neuralzome/flo_edge/README.md

# Flo Edge

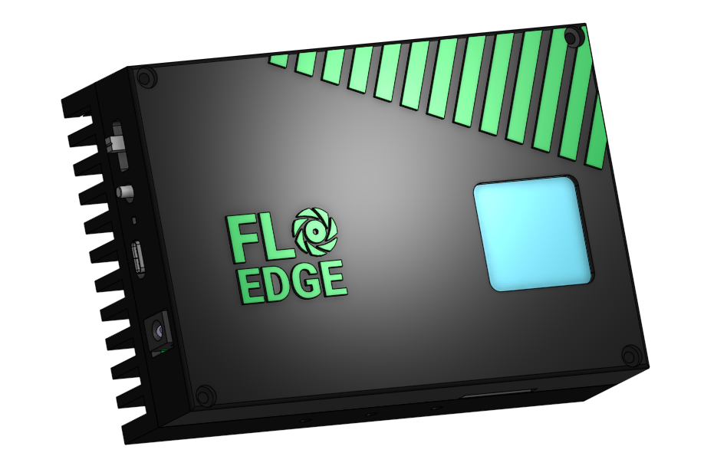
[picture p1: flo_edge.png]
flo_edge


> Mobile phone SOM based compute, sensor & comms platform for ai and robotics application

## Reference
1. [aidlux](https://www.youtube.com/watch?v=y_1fQNMngR8)
2. [comma ai](https://comma.ai/)
