neuralzome/flo_edge/pocof1/README.md

# Pocophone f1

Poco F1

* [Teardown](https://www.youtube.com/watch?v=L5VWWba0coY)
* [Schematic](./schematic.pdf)
