neuralzome/flo_edge/flo_pcb/pcba.png

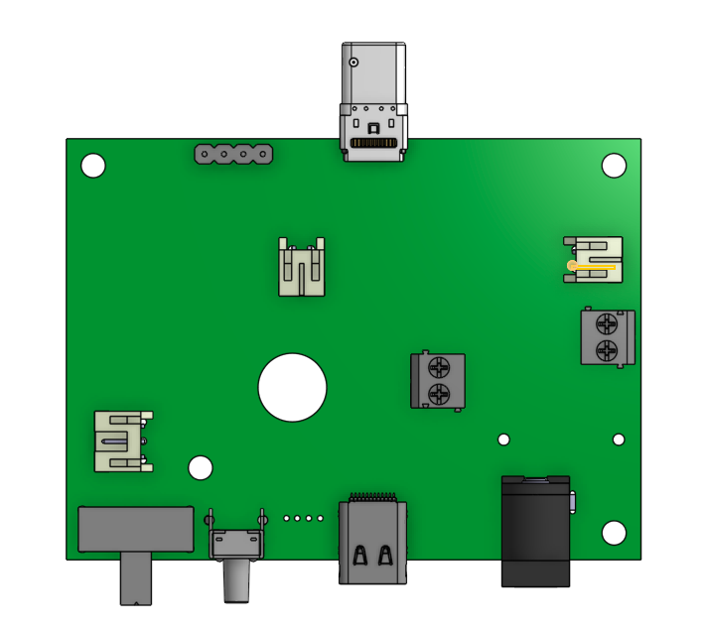
flo_pcb/pcba.png
