neuralzome/flo_edge/pocof1/imgs/bms_pcb.png

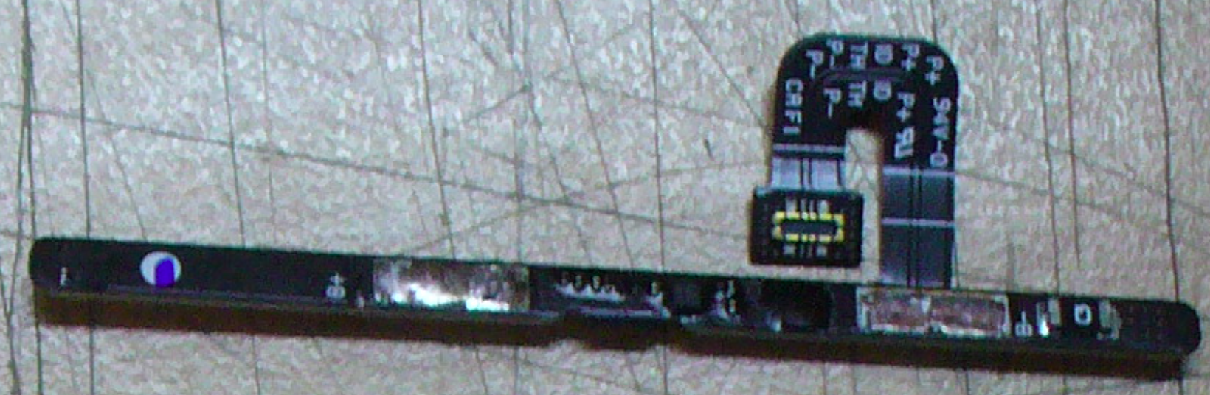
pocof1/imgs/bms_pcb.png
