neuralzome/flo_edge/pocof1/imgs/charging_pcb_back.png

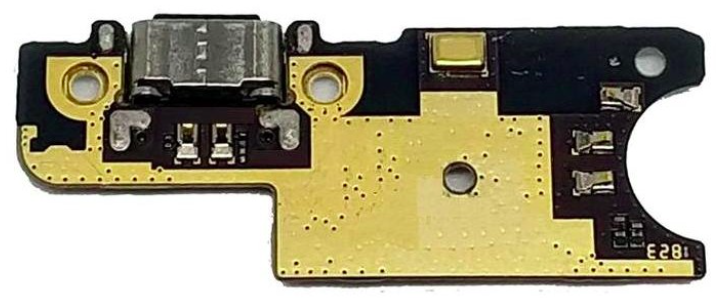
pocof1/imgs/charging_pcb_back.png
