neuralzome/flo_edge/pocof1/imgs/charging_pcb_front.png

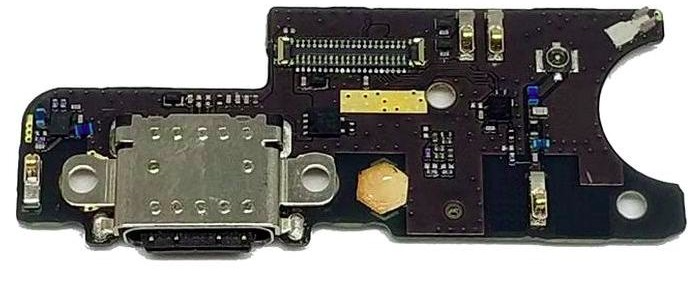
pocof1/imgs/charging_pcb_front.png
