neuralzome/flo_edge/pocof1/imgs/signal_cable.png

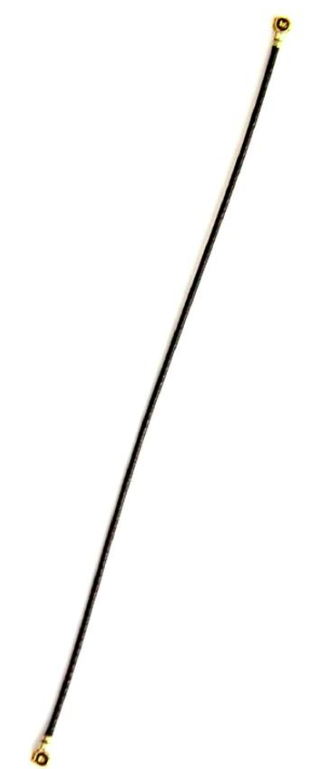
pocof1/imgs/signal_cable.png
