neuralzome/flo_edge/pocof1/imgs/som_back.png

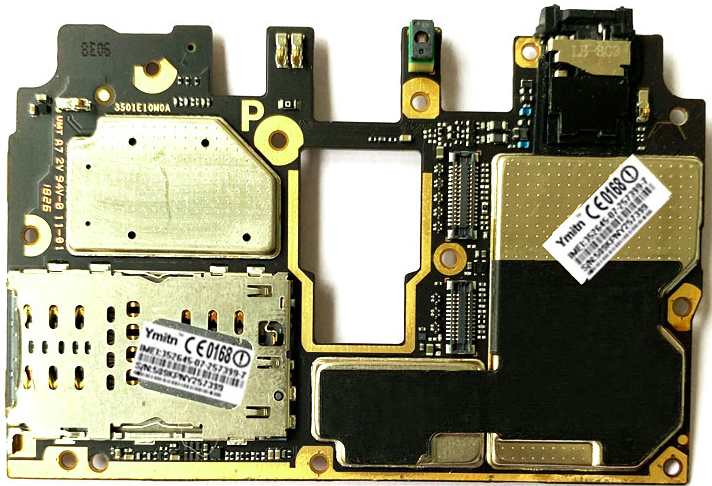
pocof1/imgs/som_back.png
