neuralzome/flo_edge/pocof1/imgs/som_front.png

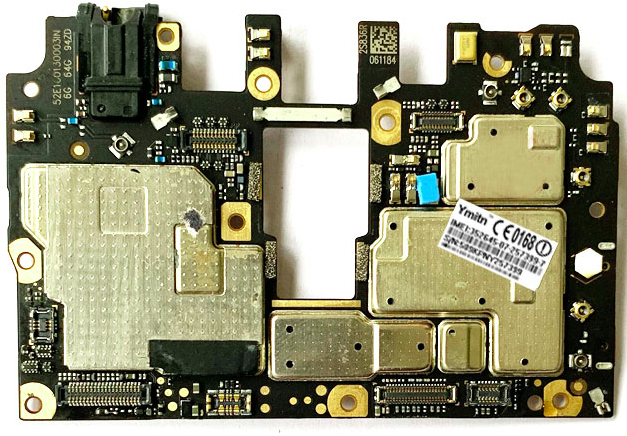
pocof1/imgs/som_front.png
