neuralzome/flo_edge/flo_pcb/bom.xls

BOM: FLO Mobility V0.0
Assembly Part Number:
Company Name:
Item # | Reference designators | Device | Part description/ specs (optional, but recommended) | Size / Footprint (optional) | Value (optional) | Manfacturer (optional) | Manufacturer Part # | Vendor (optional) | Vendor Part Number (optional) | Quantity per board | Unit Price MOQ 1 | Total MOQ 1 | Unit Price MOQ 10 | Total MOQ 10 | Unit Price MOQ 100 | Total MOQ 100 | Comments
1 | R1 | Resistor | RES 1M OHM 5% 1/10W 0603 | R0603 | 1M | WR06X105 JTL | Walsin Technology Corporation |  | 1292-WR06X105JTLCT-ND | 1 | 0.1 | 0.1
2 | R2,R18,R3 | Resistor | RES 10K OHM 1% 1/8W 0603 | R0603 | 10K | Stackpole Electronics Inc | RNCP0603FTD10K0 |  | RNCP0603FTD10K0CT-ND | 3 | 0.1 | 0.3
3 | R6,R10,R20,R14,R5,R9,R8,R4,R15,R19,R16 | Resistor | RES 1K OHM 1% 1/8W 0603 | R0603 | 1K | Stackpole Electronics Inc | RNCP0603FTD1K00 |  | RNCP0603FTD1K00CT-ND | 11 | 0.1 | 1.1
4 | R12,R13,R21,R7,R11 | Resistor | RES 100K OHM 1% 1/10W 0603 | R0603 | 100K | YAGEO | RC0603FR-07100KL |  | 311-100KHRCT-ND | 9 | 0.1 | 0.9
5 | R17 | Resistor |  | R0603 | 45.3K |  |  |  |  | 1 |  | 0
6 | C1, C2, | Capacitor | CAP CER 20PF 50V C0G/NP0 0603 | C0603 | 20pF | Samsung Electro-Mechanics | CL10C200JB8NNNC |  | 1276-1187-1-ND | 2 | 0.1 | 0.2
7 | C4,C7,C3,C5,C6 | Capacitor | CAP CER 1UF 25V X7R 0603 | C0603 | 1uF | Samsung Electro-Mechanics | CL10B105KA8NNNC |  | 1276-1184-1-ND | 5 | 0.1 | 0.5
8 | C9 | Capacitor | CAP CER 0.1UF 25V X7R 0603 | C0603 | 0.1uF | Samsung Electro-Mechanics | CL10B104KA8NNNC |  | 1276-1006-1-ND | 1 | 0.1 | 0.1
9 | C15 | Capacitor |  | C0603 | 400uF |  |  |  |  |  |  | 0
10 | C8,C10,C11 | Capacitor | CAP CER 10UF 35V X5R 0603 | C0603 | 10uF | Murata Electronics | GRM188R6YA106MA73J |  | 490-GRM188R6YA106MA73JCT-ND | 3 | 0.24 | 0.72
11 | Q1, | MOSFET N-CH | MOSFET N-CH 30V 3.6A SOT23 | SOT-23-3 |  | Diodes Incorporated | DMG3406L-13 |  | DMG3406L-13DITR-ND | 1 | 0.44 | 0.44
12 | Q2, Q3, Q4, Q5, | TRANS NPN | TRANS NPN 45V 0.5A TO236AB | SOT-23-3 |  | Nexperia USA Inc. | BC817-25_215 |  | 1727-2918-1-ND | 4 | 0.16 | 0.64
13 | L1, | Inductor | FIXED IND 3.3UH 11.4A 12.8 MOHM |  | 33uH | KEMET | MPXV1D1040L3R3 |  | 399-MPXV1D1040L3R3DKR-ND | 1 | 0.87 | 0.87
14 | LED1, | LED | LED GREEN CLEAR 0805 SMD | 805 |  | Würth Elektronik | 150080GS75000 |  | 732-4983-1-ND | 1 | 0.19 | 0.19
15 | LED2, | LED | RGB LAMP |  | RGB | Everlight Electronics Co Ltd | EALP05RDMRGBA0 |  | 1080-EALP05RDMRGBA0-ND | 1 | 1.63 | 1.63
16 | CR1 | TVS Diode | TVS DIODE 20VWM 34VC DFN1006-2 |  |  | Diodes Incorporated | D20V0L1B2LP-7B |  | D20V0L1B2LP-7BDICT-ND | 1 | 0.27 | 0.27
17 | D1, D2, D3, | Diode | DIODE SCHOTTKY 30V 800MA USC |  |  | Toshiba Semiconductor and Storage | CUS08F30 |  | CUS08F30H3FCT-ND | 3 | 0.33 | 0.99
18 | J1, | Programming Conn | CONN HEADER VERT 4POS 2.54MM |  |  | Sullins Connector Solutions | PREC004SAAN-RC |  | S1012EC-04-ND | 1 | 0.12 | 0.12
19 | J2, | KeyPad | CONN HEADER R/A 3POS 2MM |  |  | JST Sales America Inc. | S3B-PH-K-S(LF)(SN) |  | 455-1720-ND | 1 | 0.19 | 0.19
20 | J3 | Temp | CONN HEADER R/A 2POS 2MM |  |  | JST Sales America Inc. | S2B-PH-K-S(LF)(SN) |  | 455-1719-ND | 1 | 0.17 | 0.17
21 | J4, J7 | Fan | TERM BLK 2POS SIDE ENT 3.5MM PCB |  |  | TE Connectivity AMP Connectors | 1776275-2 |  | A98036-ND | 2 | 0.44 | 0.88
22 | J5 | USB-C-F | CONN RCP USB3.1 TYPEC 24P SMD RA |  |  | Assmann WSW Components | CONN RCP USB3.1 TYPEC 24P SMD RA |  | AE11237DKR-ND | 1 | 3.32 | 3.32
23 | J6, | USB-C-M | USB TYPE C, PLUG, SMT , G/F, RIG |  |  | GCT | USB4155-03-C |  | 2073-USB4155-03-CDKR-ND | 1 | 1.69 | 1.69
24 | J8, | CONN | CONN PWR JACK 2.1X5.5MM SOLDER |  |  | MPD (Memory Protection Devices) | EJ508A |  | EJ508A-ND | 1 | 1.38 | 1.38
25 | S1, | Switch | SWITCH TACTILE SPST-NO 0.05A 12V |  |  | E-Switch | TL1105SF250Q |  | EG1840-ND | 1 | 0.37 | 0.37
26 | SW1 | Switch | SWITCH SLIDE SPDT 300MA 30V |  |  | C&K | SK12F17G7 |  | CKN10393-ND | 1 | 0.77 | 0.77
27 | U1 | IC REG | IC REG BUCK ADJ 5A TSOT23-6 |  |  | Texas Instruments | TPS565208DDCR |  | 296-48755-1-ND | 1 | 1.48 | 1.48
28 | U2, | IC REG | IC REG LINEAR 3.3V 1A SOT223 |  | 3.3V | onsemi | NCV1117ST33T3G |  | NCV1117ST33T3GOSCT-ND | 1 | 0.71 | 0.71
29 | U3, | MCU | IC MCU 32BIT 256KB FLASH 48LQFP |  |  | STMicroelectronics | STM32F030CCT6 |  | 497-17296-ND | 1 | 4.08 | 4.08
30 | FB2,FB1 | FERRITE | FERRITE BEAD 30 OHM 0805 1LN |  |  | Würth Elektronik | 742792030 |  | 732-742792030CT-ND | 1 | 0.23 | 0.23
31 | Y1, | CRYSTAL | CRYSTAL 8.0000MHZ 20PF SMD |  | 8MHz | Abracon LLC | ABLS-8.000MHz-20-B-3-H-T |  | 535-14944-1-ND | 1 | 0.17 | 0.17
END OF BOM |  |  |  |  |  |  |  |  |  | Total Cost Per PCB (USD): |  | 24.51 |  | 0 |  | 0
BOM Created By : Rahul Kumar
BOM Verified By :
