neuralzome/flo_edge/flo_pcb/schematics.pdf

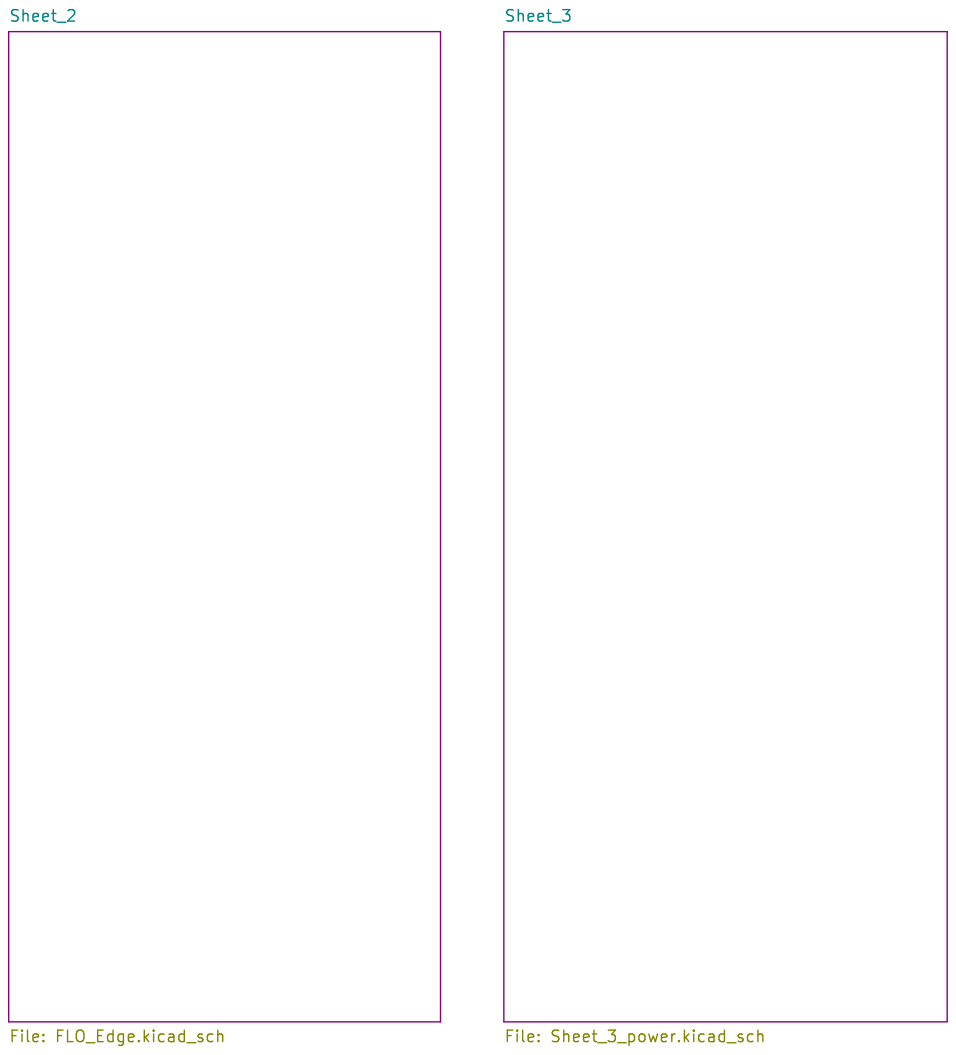
[picture p9: page 1]

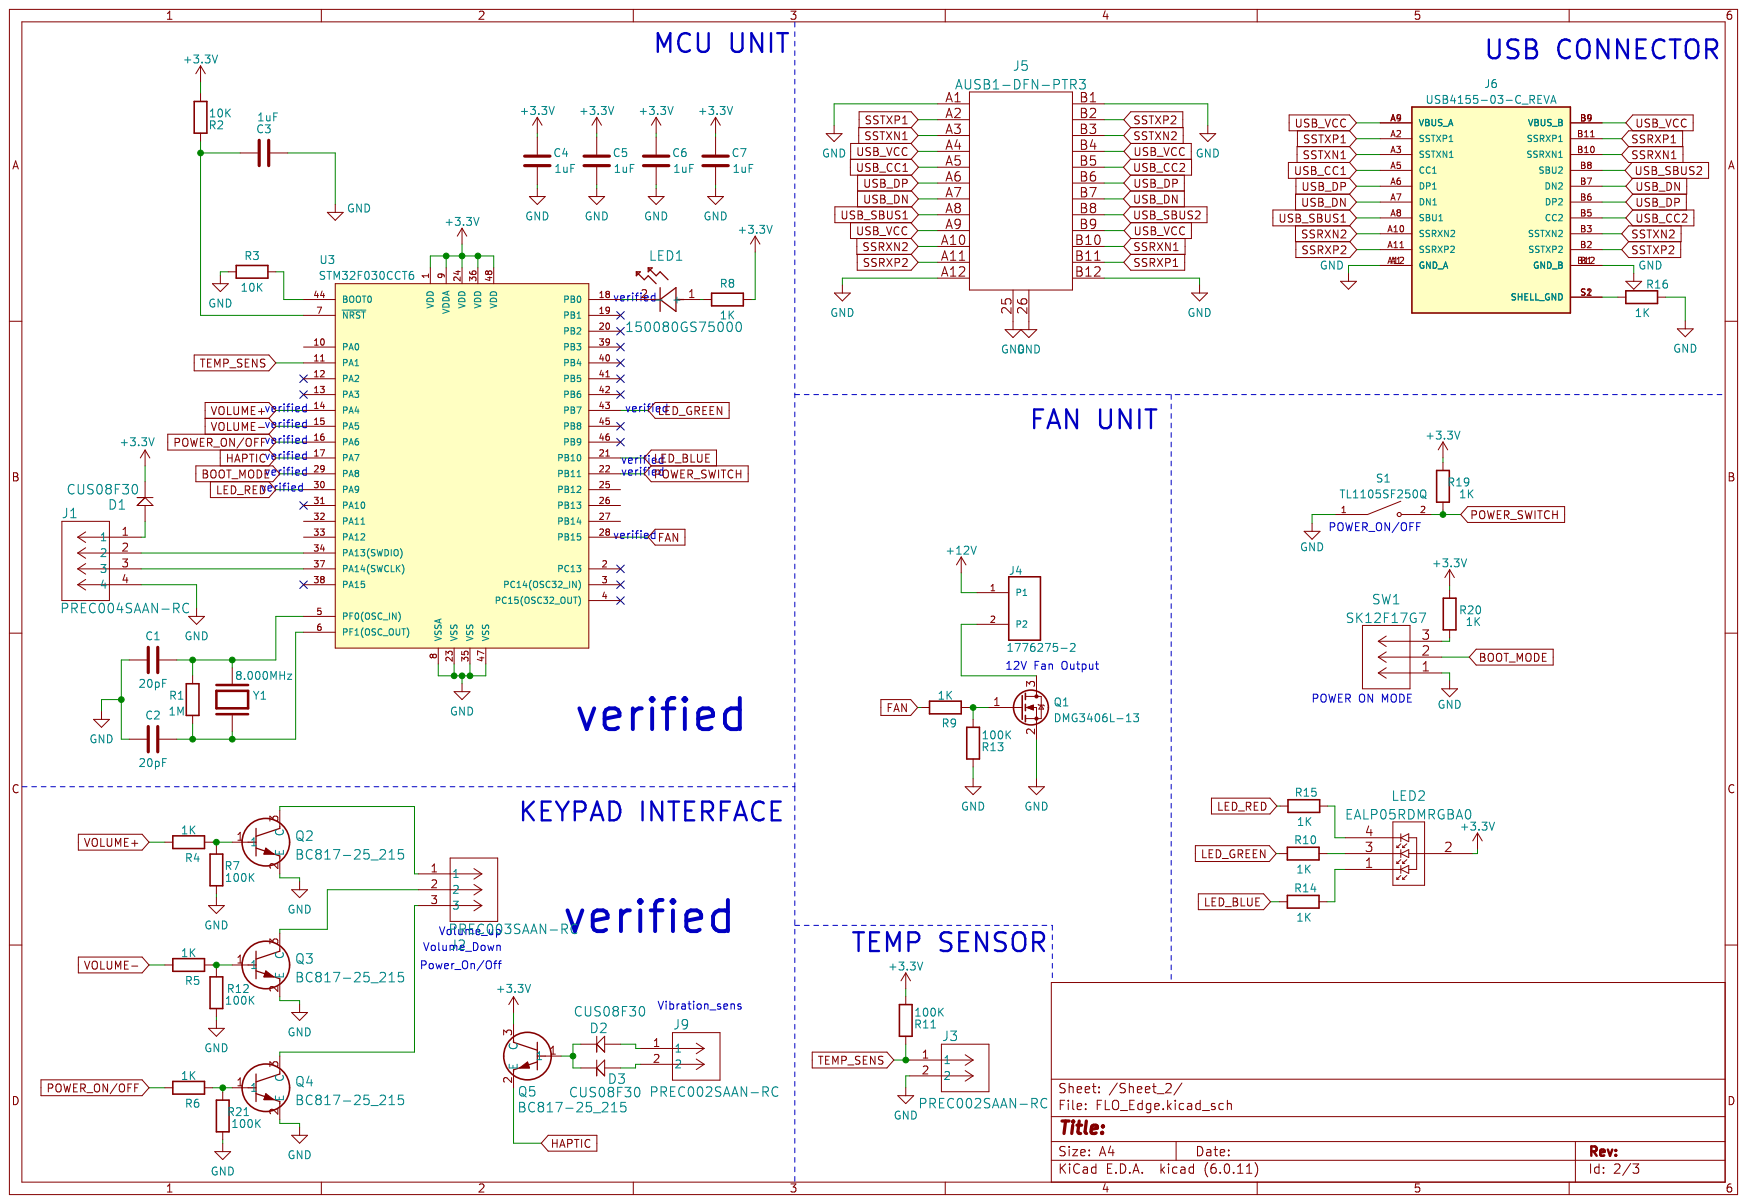
[picture p10: page 2]

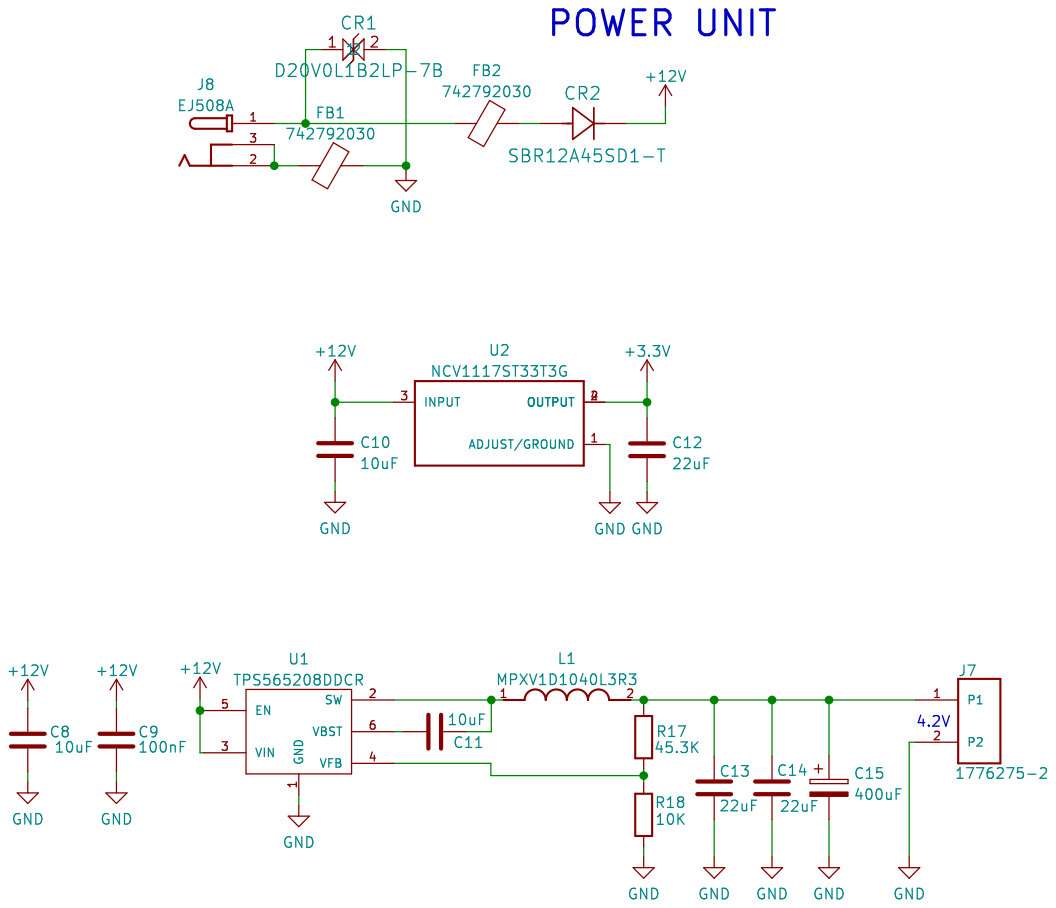
[picture p11: page 3]
