neuralzome/flo_edge/flo_pcb/layout.pdf

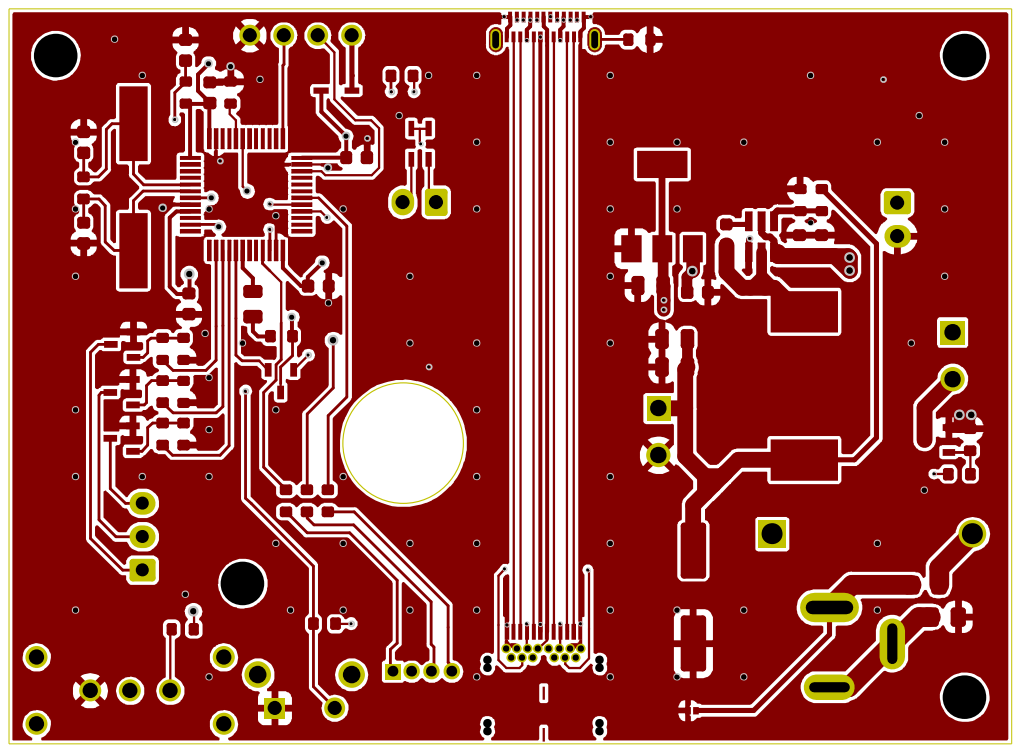
[picture p12: page 1]

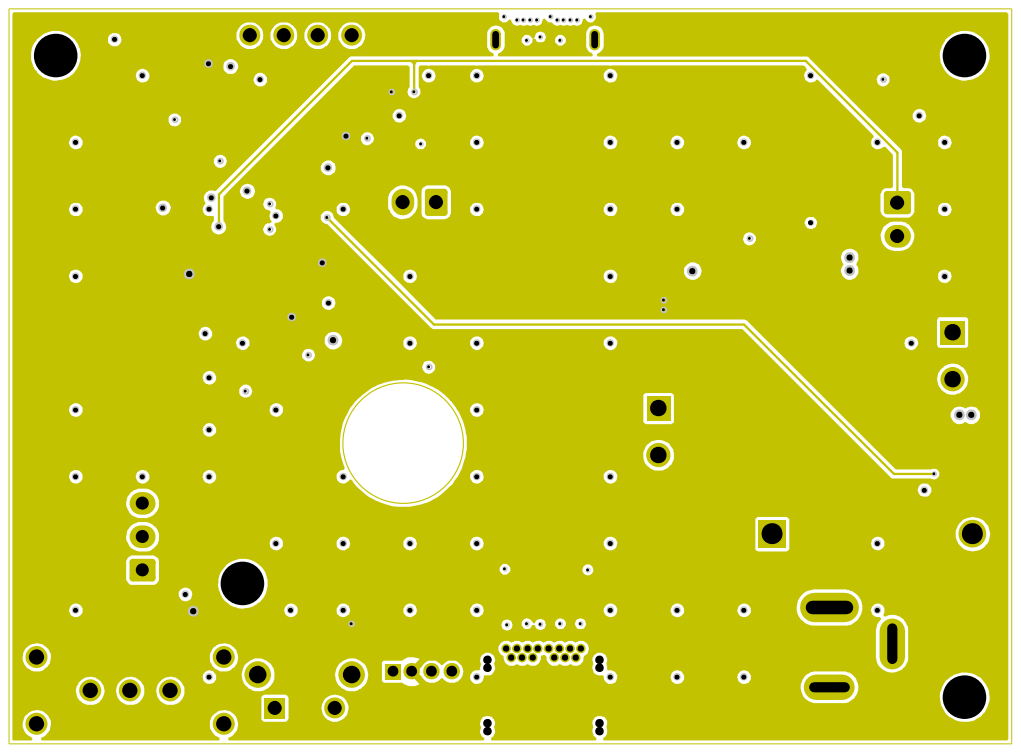
[picture p13: page 2]

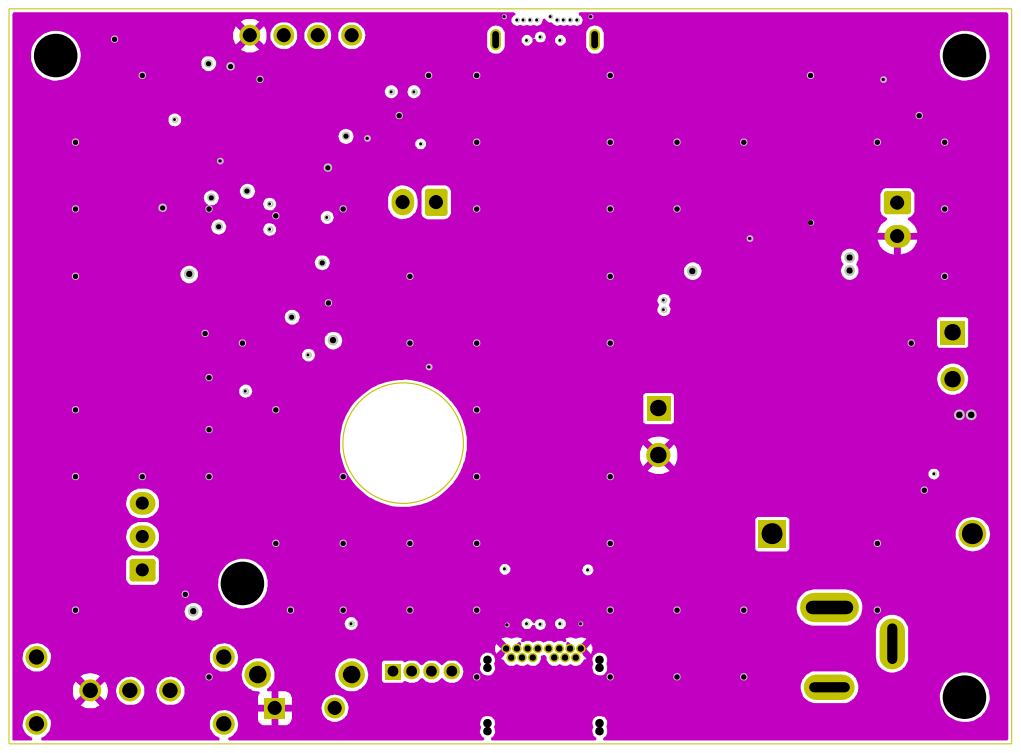
[picture p14: page 3]

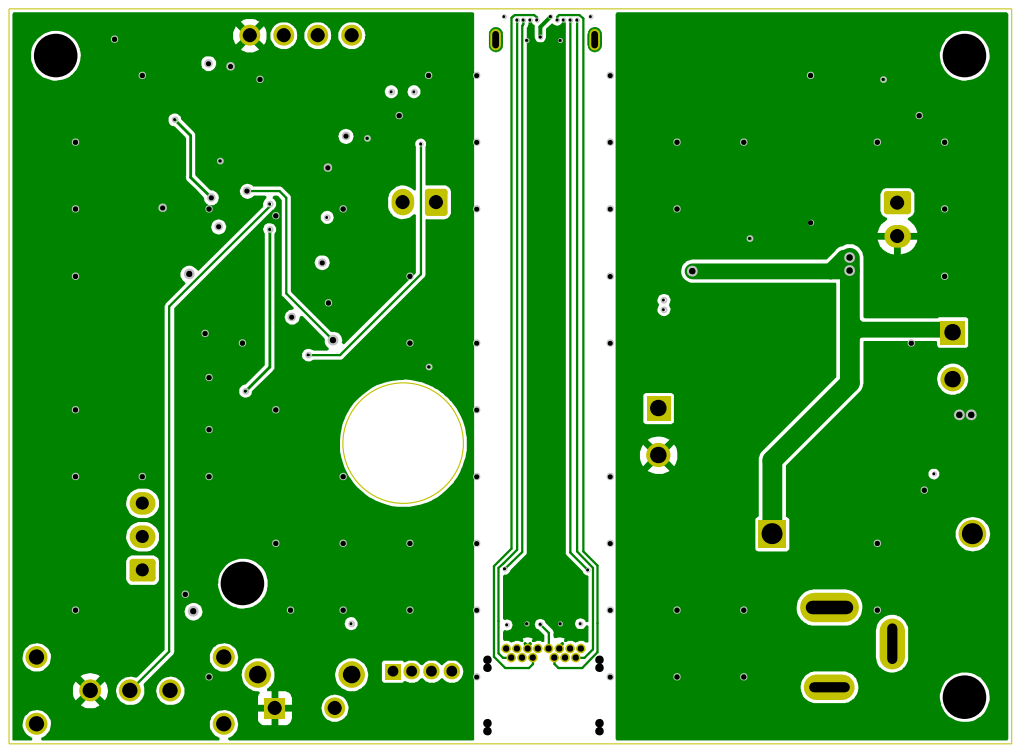
[picture p15: page 4]

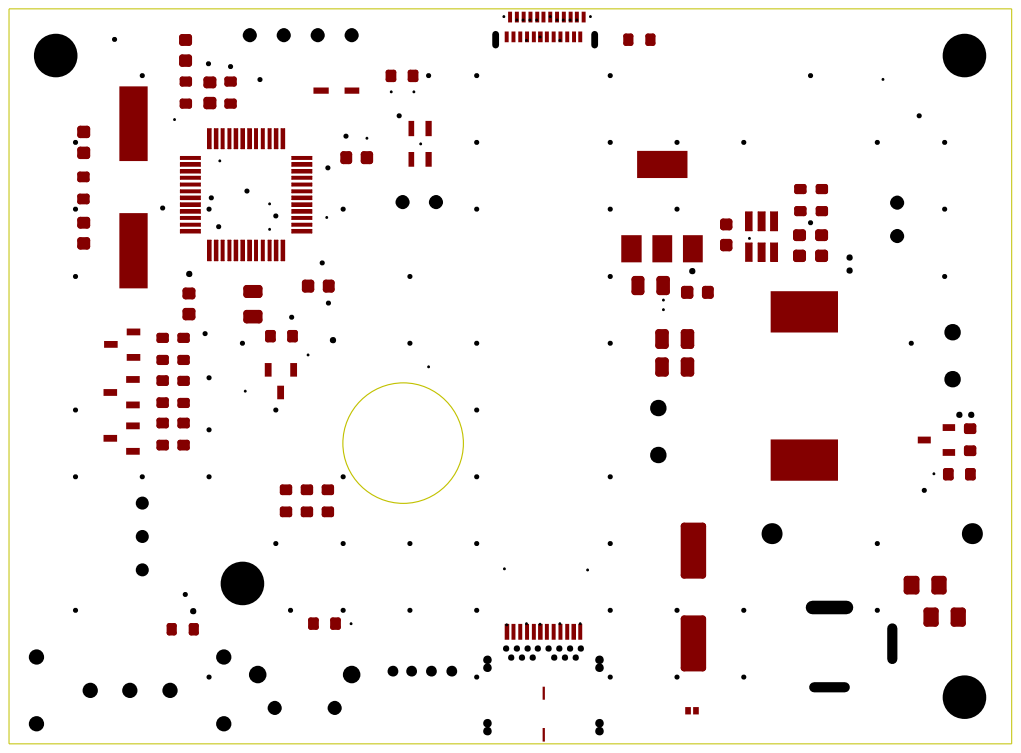
[picture p16: page 5]

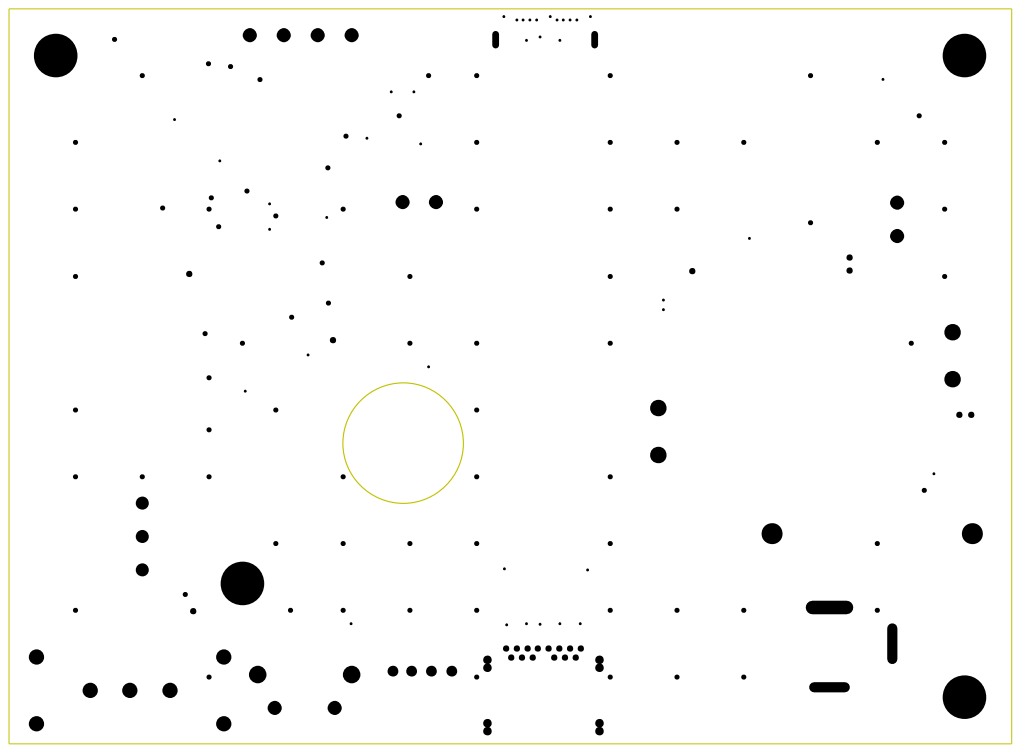
[picture p17: page 6]

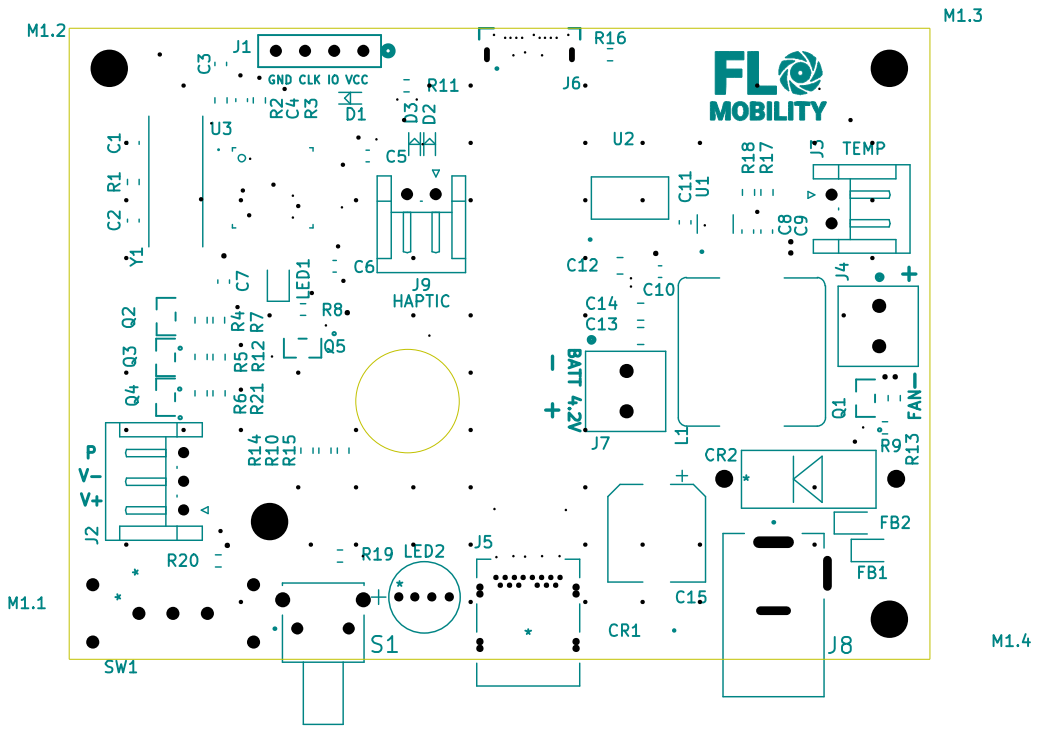
[picture p18: page 7]

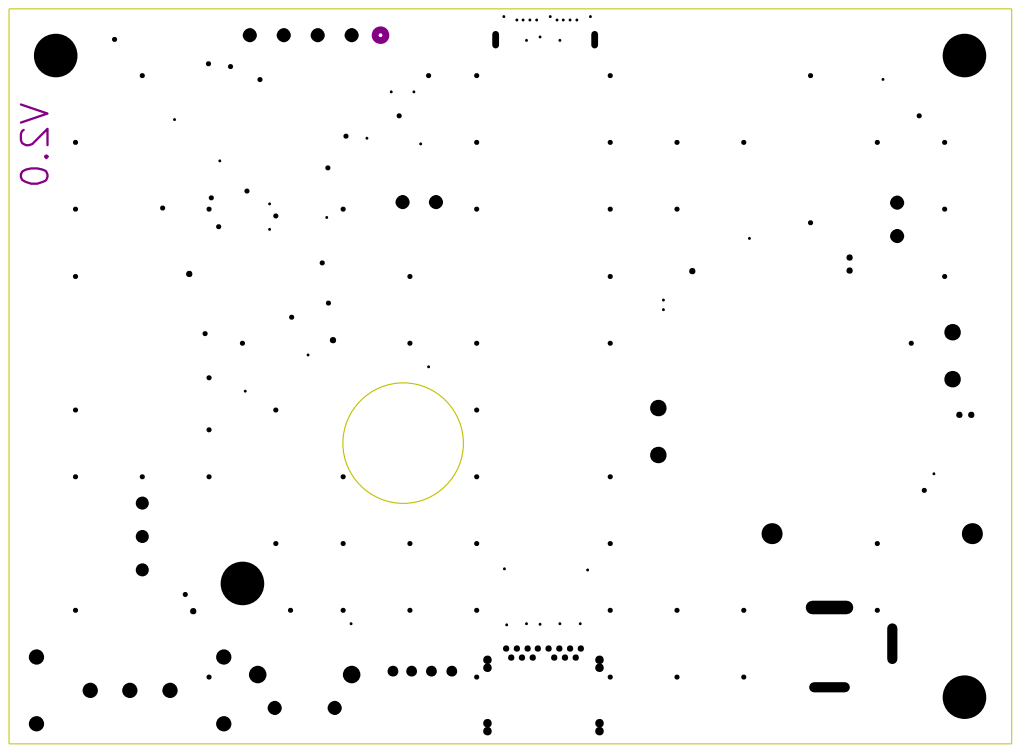
[picture p19: page 8]

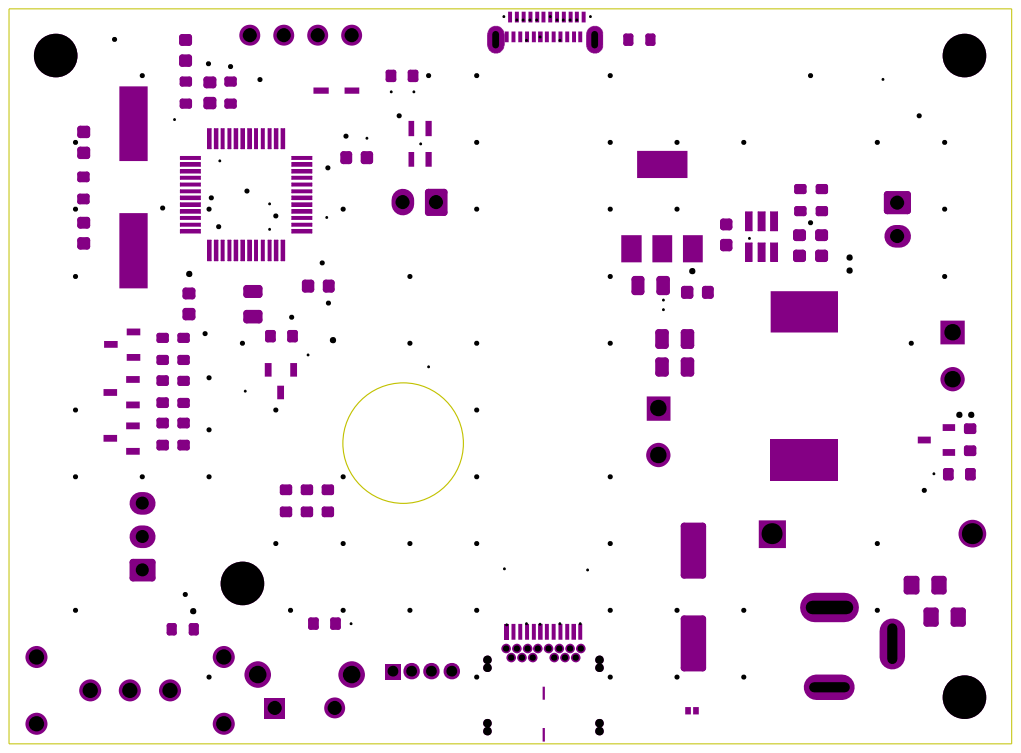
[picture p20: page 9]

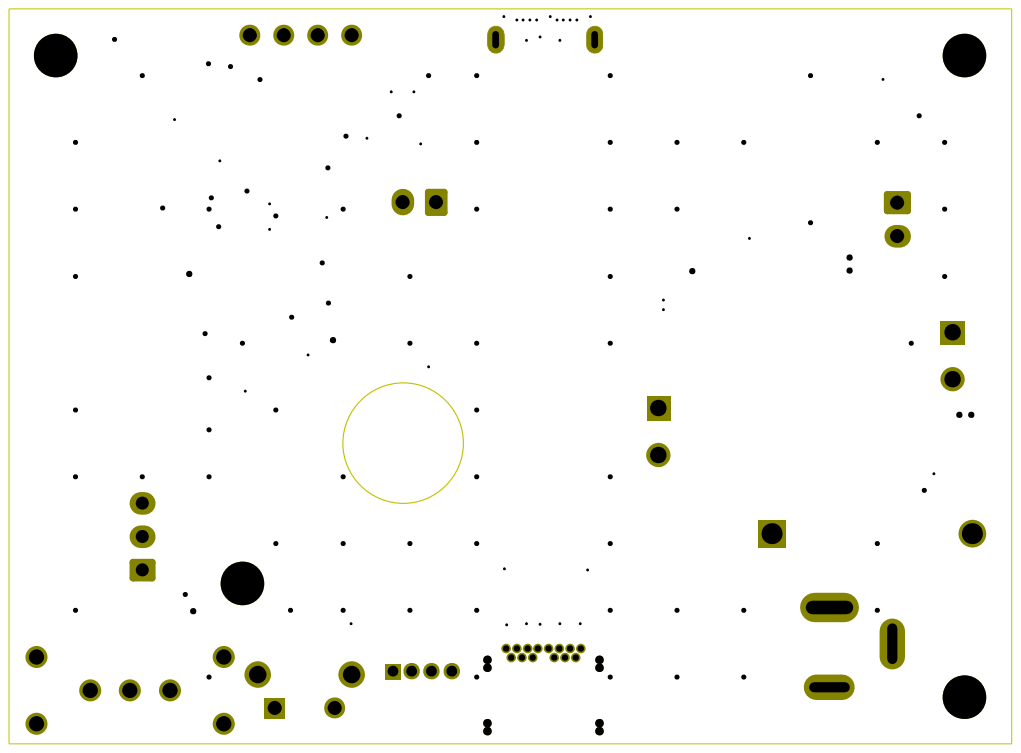
[picture p21: page 10]

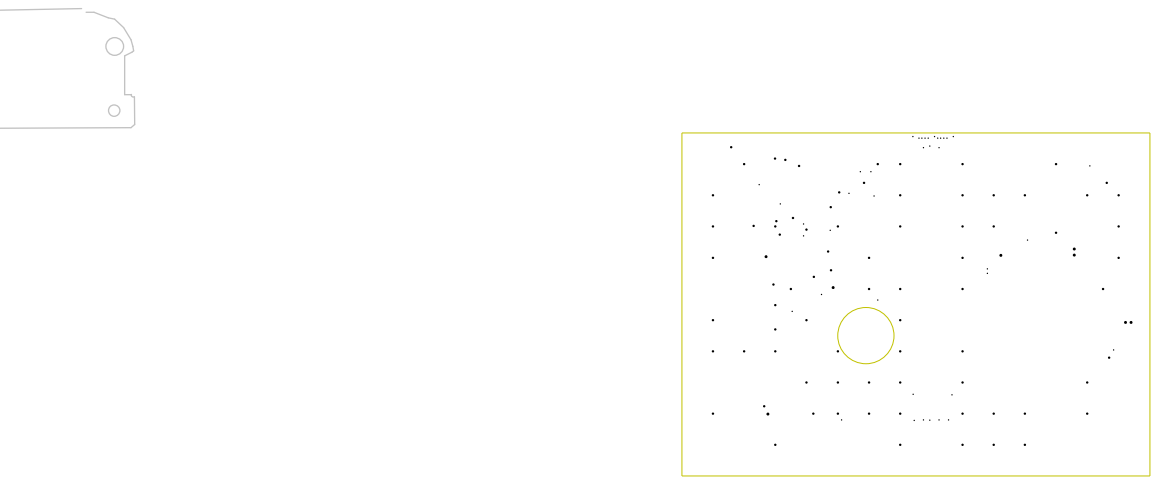
[picture p22: page 11]

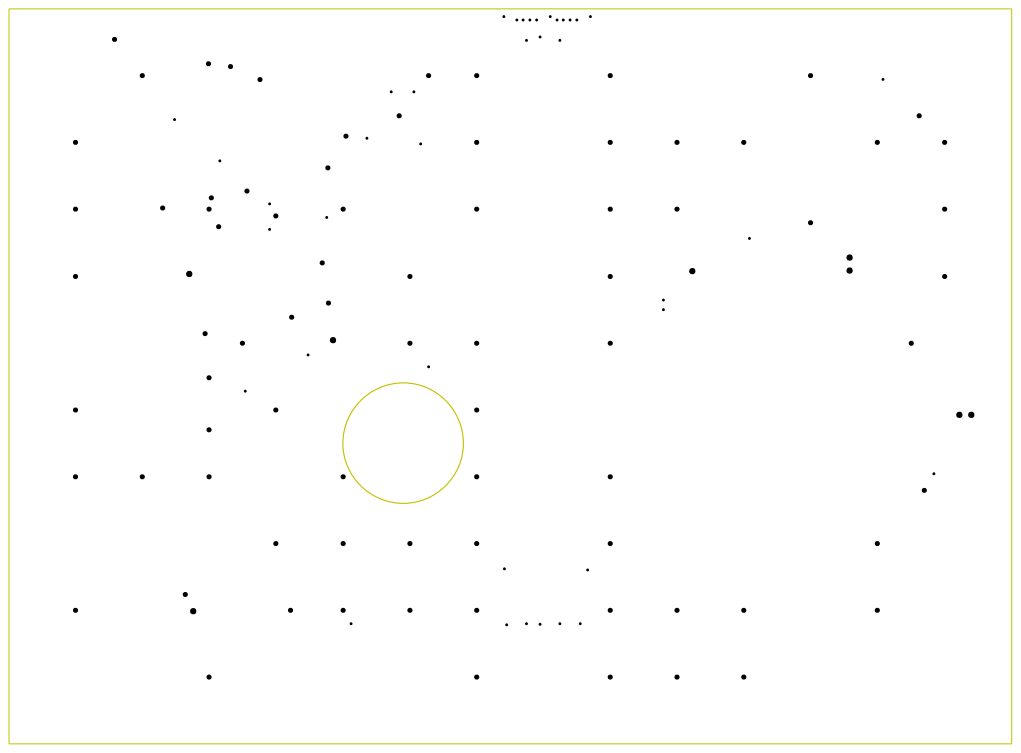
[picture p23: page 12]

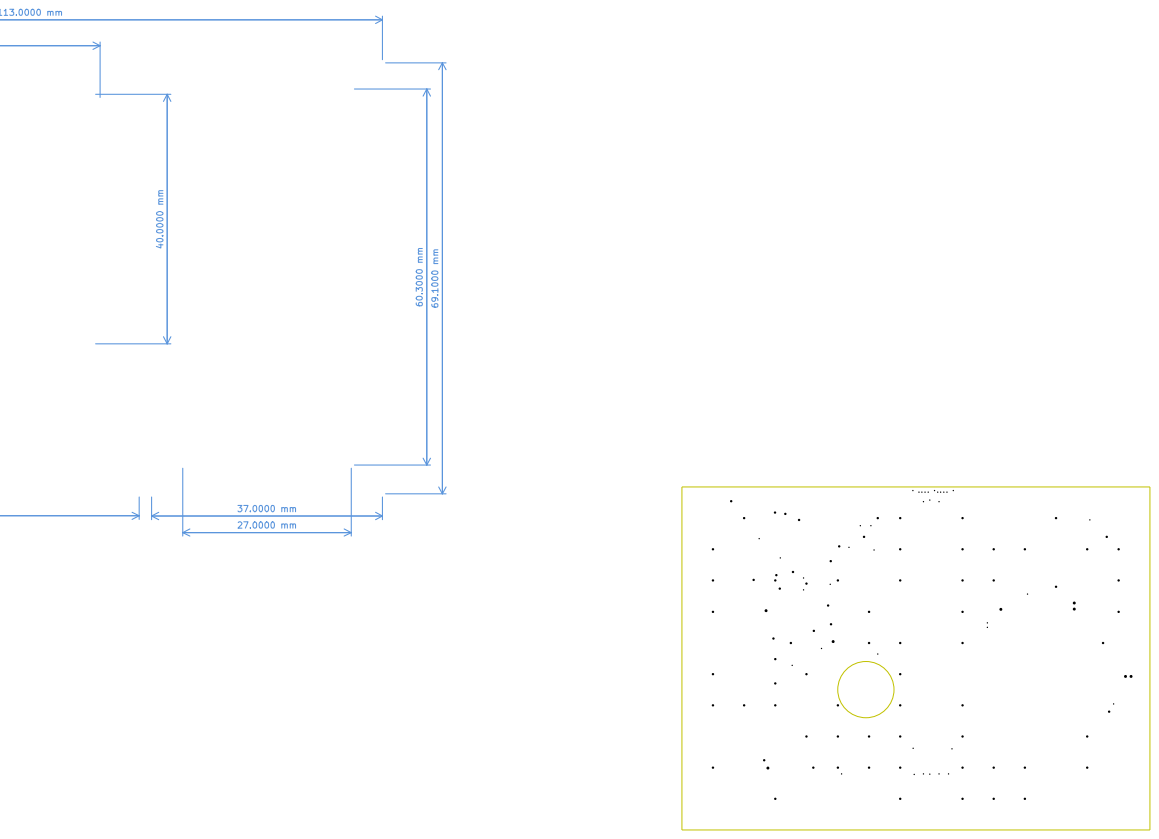
[picture p24: page 13]
