neuralzome/flo_edge/flo_pcb/firmware/flo_edge/Core/Inc/main.h

#define VM_Pin GPIO_PIN_4
#define VM_GPIO_Port GPIOA
#define VP_Pin GPIO_PIN_5
#define VP_GPIO_Port GPIOA
#define P_Pin GPIO_PIN_6
#define P_GPIO_Port GPIOA
#define HAPTIC_Pin GPIO_PIN_7
#define HAPTIC_GPIO_Port GPIOA
#define DEBUG_LED_Pin GPIO_PIN_0
#define DEBUG_LED_GPIO_Port GPIOB
#define RGB_LED_RED_Pin GPIO_PIN_10
#define RGB_LED_RED_GPIO_Port GPIOB
#define PUSH_BUTTON_Pin GPIO_PIN_11
#define PUSH_BUTTON_GPIO_Port GPIOB
#define BOOT_MODE_Pin GPIO_PIN_8
#define BOOT_MODE_GPIO_Port GPIOA
#define RGB_LED_BLUE_Pin GPIO_PIN_9
#define RGB_LED_BLUE_GPIO_Port GPIOA
#define RGB_LED_GREEN_Pin GPIO_PIN_7
#define RGB_LED_GREEN_GPIO_Port GPIOB
