neuralzome/flo_edge/(commit log)

2022-11-04 Add motherboard stl file
    [motherboard.stl]
2022-11-05 Add charging_pcb cad
    [charging_pcb.stl]
2022-11-08 Add dirs for carrier_board and 3d printed case
2022-11-08 init attachments
2023-04-14 Update flo_edge pcb
    [bom.xls]
2023-04-17 Add gerber file
